LameFingers/armor-fall-detection/evidence/hardware/README.md

# Hardware Evidence

Photographs documenting the physical build of the ARMOR prototype.

---

## Receiver board

**breadboard1-receiver-build** — Receiver (LILYGO T3 V1.6.1) assembled on breadboard during initial build and functional test — RGB LED, KY-006 buzzer, acknowledge button, and LoRa antenna.

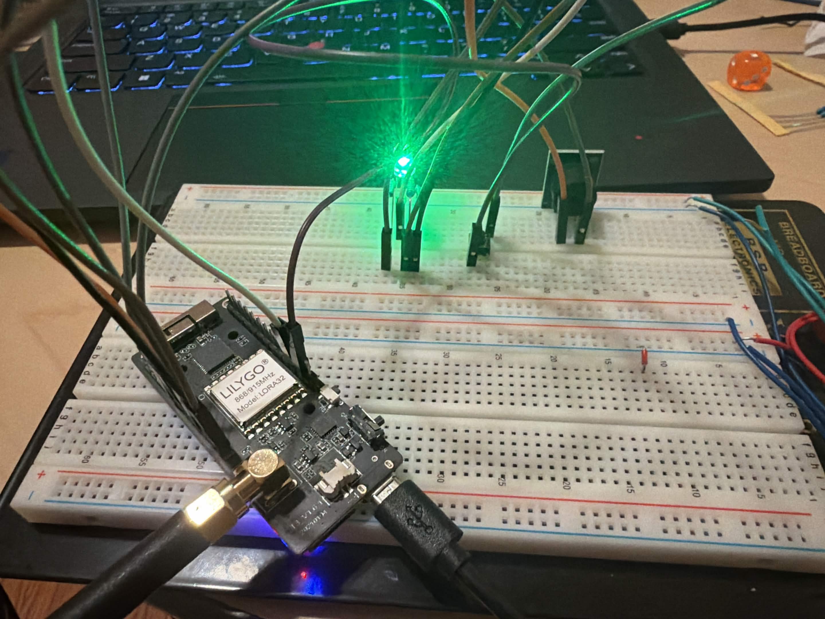
[picture p1: evidence/hardware/breadboard1-receiver-build.jpg]
Receiver breadboard build


---

**receiver-closeup** — Close-up of the finished receiver board showing component placement and wiring.

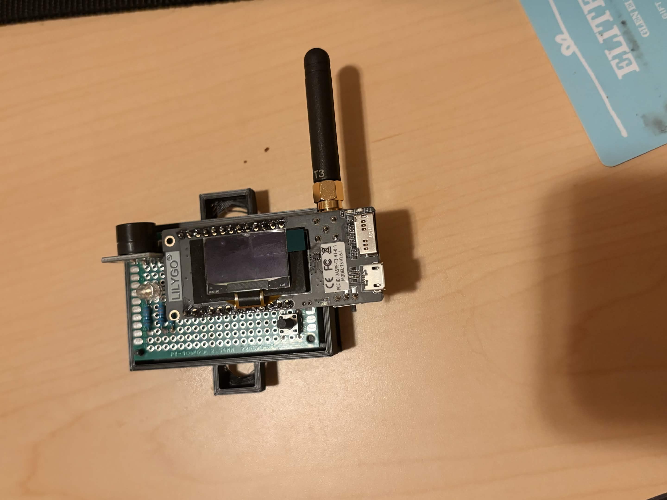
[picture p2: evidence/hardware/receiver-closeup.jpg]
Receiver close-up


---

## Sender board

**breadboard2-sender-build** — Sender (LILYGO T3 V1.6.1 + DFRobot Gravity BMI160) assembled on breadboard — IMU, RGB LED, KY-006 buzzer, cancel button, and LiPo battery connector.

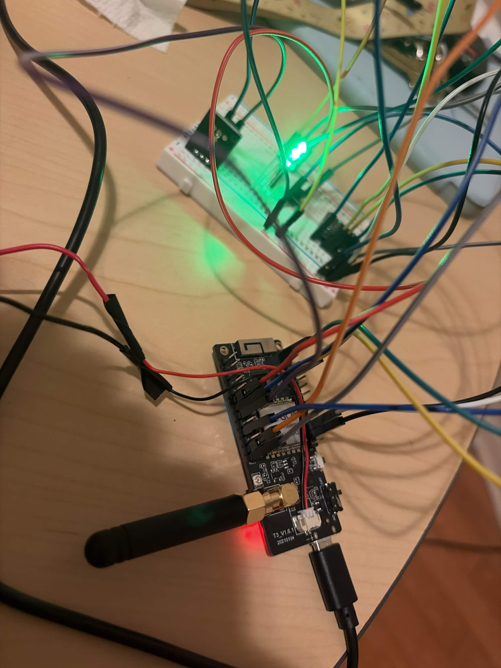
[picture p3: evidence/hardware/breadboard2-sender-build.jpg]
Sender breadboard build


---

**breadboard3-sender-build** — Sender breadboard build from a second angle — showing BMI160 I²C wiring and power connections.

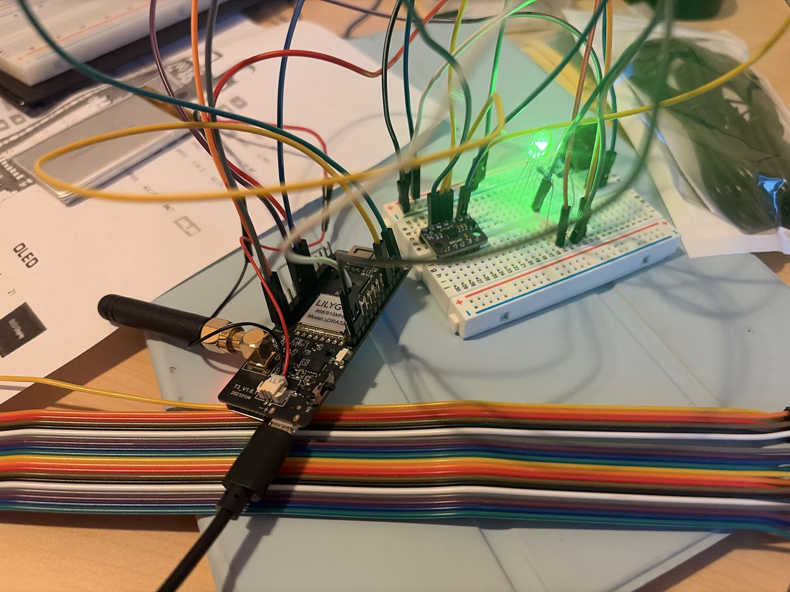
[picture p4: evidence/hardware/breadboard3-sender-build.jpg]
Sender breadboard build angle 2


---

**sender-closeup** — Close-up of the finished sender (wearable) board showing the full assembly.

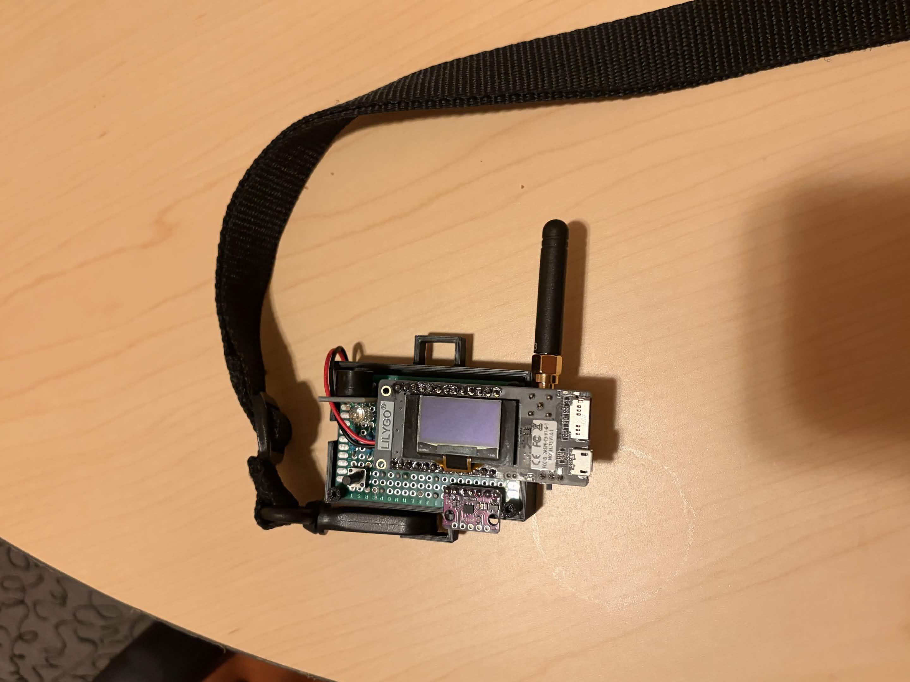
[picture p5: evidence/hardware/sender-closeup.jpg]
Sender close-up


---

## Related documentation

- [`docs/hardware-wiring.md`](../../docs/hardware-wiring.md) — GPIO pin assignments and breadboard wiring for both boards
- [`hardware/README.md`](../../hardware/README.md) — Bill of materials for the v1 prototype
