LameFingers/armor-fall-detection/(commit log)

2026-08-12 Add architecture documentation for Armor system
    Document the architecture of the Armor system, detailing its overview, information flow, main subsystems, and current status.
2026-08-12 Create IBM Bob Development Log
    Document the purpose and current status of IBM Bob as a development partner.
2026-08-12 Add testing and validation plan for Armor project
    This document outlines the testing and validation plan for the Armor project, detailing evaluation areas, planned activities, current status, and safety notes.
2026-08-12 Add README for Armor Machine Learning project
    This README outlines the workflow for developing a fall detection model using Armor's on-device data. It includes planned steps, potential input features, data privacy measures, and the current status of the project.
2026-08-12 Create README.md for Armor firmware project
    Added initial README for Armor firmware project, outlining responsibilities, platform, and current status.
2026-08-12 Had BOB look over everything, fix board issue, planned out strucutre, and gave tips. Overall was used as a test run and documentation purposes.
2026-08-19 Added ardunio firmware, pin diagrams, further testing goals, and defined hardware
2026-08-20 Added firmware implementation for buttons and updated appropriate comments
2026-09-04 Rename ML zip to clean name and fix all doc references
    - Rename ml/ei-armor-fall-detection-binary-v1-arduino-1.0.7-impulse-#1.zip
    to ml/armor-fall-detection-binary-v1.zip so it matches the name used
    in firmware (#include), ml/README.md, and root README.md
    - Make the zip a clickable link in ml/README.md (contents table,
    install step 3, and retraining step 4)
    - Remove broken evidence/ link from root README.md (folder was deleted);
    replace with ml/README.md entry
2026-09-04 Add evidence folder with hardware photos, ML training screenshots, and on-device validation
    - evidence/hardware/: breadboard build photos (receiver + sender) and close-up shots
    - evidence/ml-training/: Edge Impulse screenshots for all 6 training attempts
    - evidence/on-device/: first and final on-device validation results
    - evidence/README.md, hardware/README.md, ml-training/README.md, on-device/README.md: full READMEs with image tables and cross-links
    - docs/testing-validation.md: updated ml-screenshots path to evidence/ml-training/; added evidence/on-device/ link after validation table
    - hardware/README.md: updated evidence/ link to evidence/hardware/
    - README.md: expanded key documentation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
2026-09-04 Add Edge Impulse configuration screenshots with detailed comments
    - evidence/ml-training/ei-data.png: dataset page (14m 48s, 441/39 split, fall_like + non_fall)
    - evidence/ml-training/ei-impulse.png: impulse design (6-axis input, spectral analysis, classifier)
    - evidence/ml-training/ei-features.png: spectral features DSP (low-pass 1.27 Hz, FFT 128pt, log spectrum)
    - evidence/ml-training/ei-classifier.png: final classifier (Dense 64->32->Dropout 0.3, 91% acc, 1ms inference)
    - evidence/ml-training/README.md: new section with image-by-image comments for all four screenshots
    - evidence/README.md: updated folder description and naming convention table for ei-* files
    - docs/testing-validation.md: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
